Karthikeya2005/buck5v/buck5v.kicad_pcb

## KiCad design buck5v.kicad_pcb (2026-10-19)

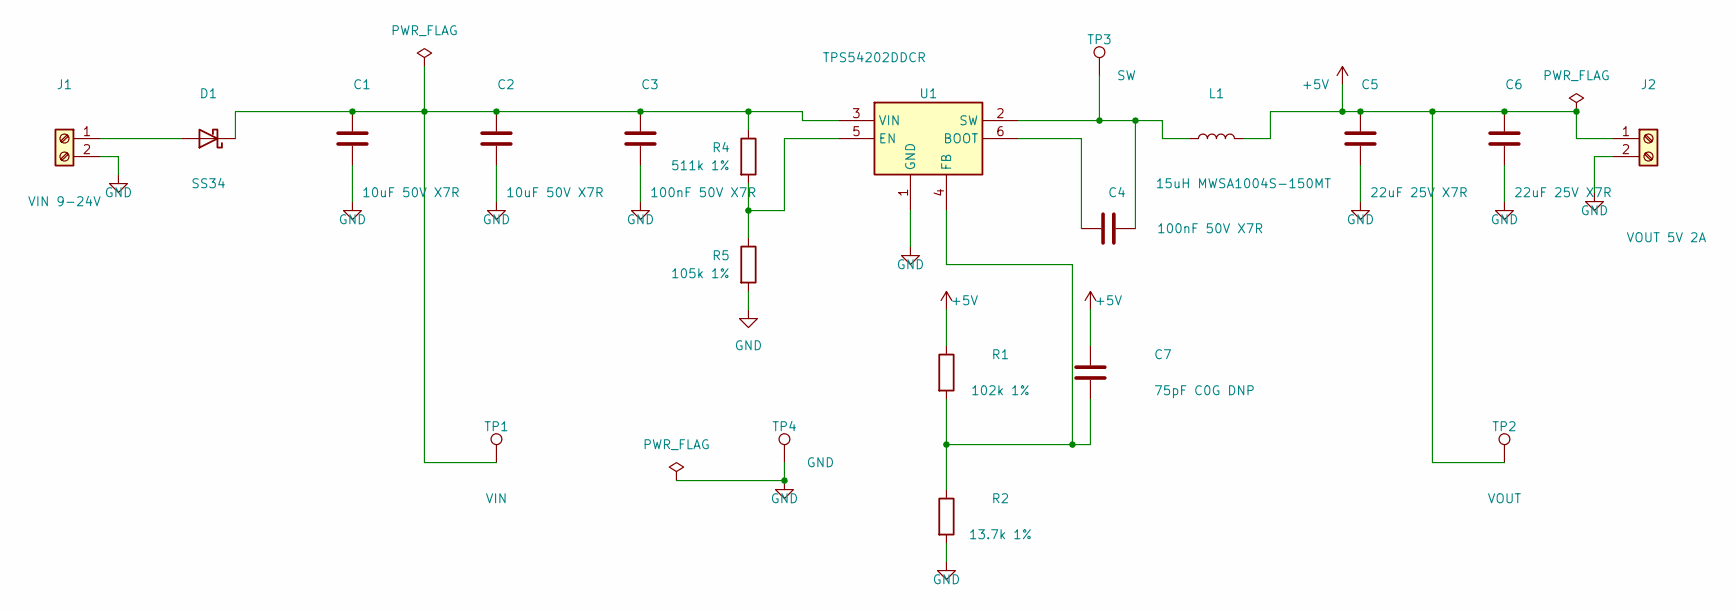
[picture p4: schematic buck5v.kicad_sch]

Parts:
C1, C2: 10uF 50V X7R; C_1210_3225Metric; MPN CL32B106KBJNNNE; LCSC C138687
C3, C4: 100nF 50V X7R; C_0603_1608Metric; MPN CL10B104KB8NNNC; LCSC C1591
C5, C6: 22uF 25V X7R; C_1210_3225Metric; MPN CL32B226KAJNNNE; LCSC C309062
C7: 75pF C0G DNP; C_0603_1608Metric
D1: SS34; D_SMA
J1: VIN 9-24V; TerminalBlock_MaiXu_MX126-5.0-02P_1x02_P5.00mm
J2: VOUT 5V 2A; TerminalBlock_MaiXu_MX126-5.0-02P_1x02_P5.00mm
L1: 15uH MWSA1004S-150MT; L_Sunlord_MWSA1004S; MPN MWSA1004S-150MT
R1: 102k 1%; R_0603_1608Metric
R2: 13.7k 1%; R_0603_1608Metric
R4: 511k 1%; R_0603_1608Metric
R5: 105k 1%; R_0603_1608Metric
TP1: VIN; TestPoint_Pad_D1.5mm
TP2: VOUT; TestPoint_Pad_D1.5mm
TP3: SW; TestPoint_Pad_D1.5mm
TP4: GND; TestPoint_Pad_D1.5mm
U1: TPS54202DDCR; TSOT-23-6_HandSoldering; MPN TPS54202DDCR; LCSC C191884

Connections:
+5V: C5.1, C6.1, C7.1, J2.1, L1.2, R1.1, TP2.1
GND: C1.2, C2.2, C3.2, C5.2, C6.2, J1.2, J2.2, R2.2, R5.2, TP4.1, U1.1 (GND)
unnamed: C1.1, C2.1, C3.1, D1.1 (K), R4.1, TP1.1, U1.3 (VIN)
unnamed: C4.1, U1.6 (BOOT)
unnamed: C4.2, L1.1, TP3.1, U1.2 (SW)
unnamed: C7.2, R1.2, R2.1, U1.4 (FB)
unnamed: D1.2 (A), J1.1
unnamed: R4.2, R5.1, U1.5 (EN)

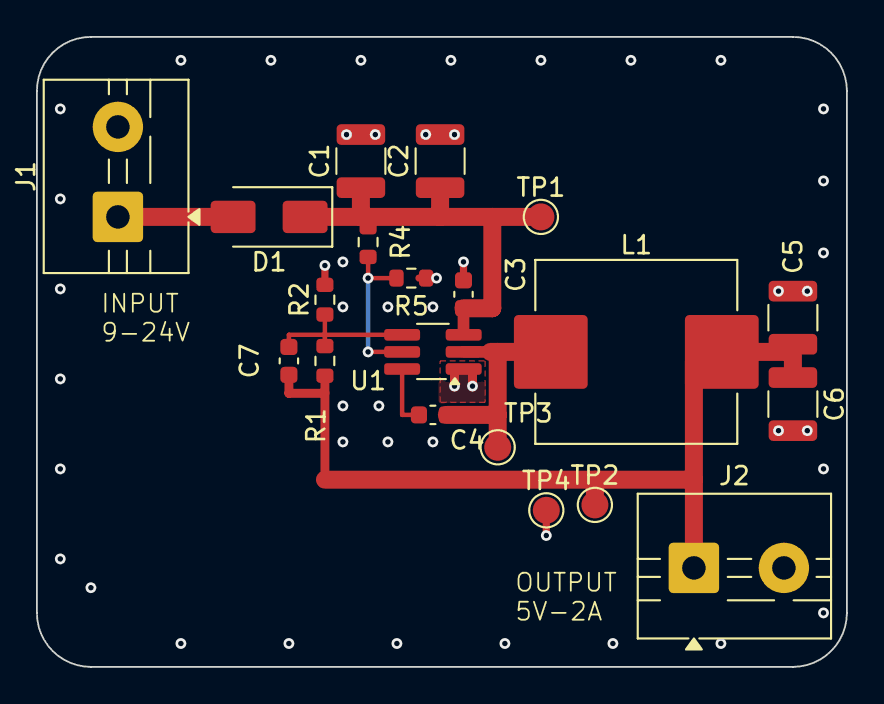
[picture p5: board buck5v.kicad_pcb from above]

Board: 2 copper layers, 45.0 x 35.0 mm, 20 parts (0 on the bottom side), 8 nets.
